unal-edigital2-labs/2021-1-w07_entrega-_final-grupo11/images/Conexion.png

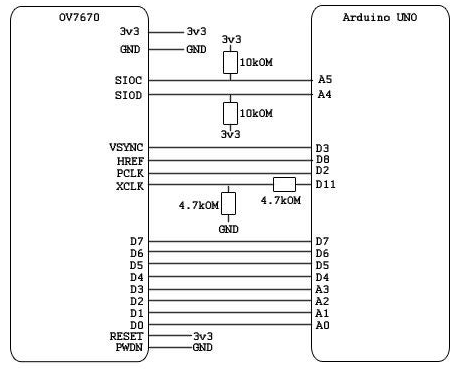
images/Conexion.png
