unal-edigital2-labs/2021-1-w07_entrega-_final-grupo11/images/test.png

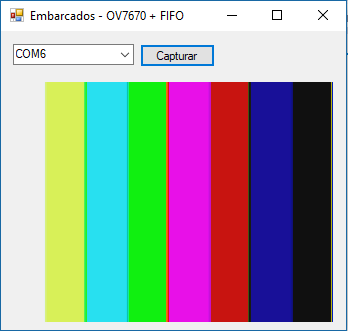
images/test.png
