unal-edigital2-labs/2021-1-w07_entrega-_final-grupo11/module/verilog/clk24_25_nexys4_clk_wiz.v

// file: clk24_25_nexys4.v
// 
// (c) Copyright 2008 - 2013 Xilinx, Inc. All rights reserved.
// 
// This file contains confidential and proprietary information
// of Xilinx, Inc. and is protected under U.S. and
// international copyright and other intellectual property
// laws.
// 
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
// CRITICAL APPLICATIONS
// Xilinx products are not designed or intended to be fail-
// safe, or for use in any application requiring fail-safe
// performance, such as life-support or safety devices or
// systems, Class III medical devices, nuclear facilities,
// applications related to the deployment of airbags, or any
// other applications that could lead to death, personal
// injury, or severe property or environmental damage
// (individually and collectively, "Critical
// Applications"). Customer assumes the sole risk and
// liability of any use of Xilinx products in Critical
// Applications, subject only to applicable laws and
// regulations governing limitations on product liability.
// 
// THIS COPYRIGHT NOTICE AND DISCLAIMER MUST BE RETAINED AS
// PART OF THIS FILE AT ALL TIMES.
// 
//----------------------------------------------------------------------------
// User entered comments
//----------------------------------------------------------------------------
// None
//
//----------------------------------------------------------------------------
//  Output     Output      Phase    Duty Cycle   Pk-to-Pk     Phase
//   Clock     Freq (MHz)  (degrees)    (%)     Jitter (ps)  Error (ps)
//----------------------------------------------------------------------------
// __clk24M__24.00000______0.000______50.0______175.595_____99.281
// __clk25M__25.00000______0.000______50.0______174.188_____99.281
//
//----------------------------------------------------------------------------
// Input Clock   Freq (MHz)    Input Jitter (UI)
//----------------------------------------------------------------------------
// __primary_________100.000____________0.010

`timescale 10ns/1ns

module clk24_25_nexys4_clk_wiz 

 (// Clock in ports
  // Clock out ports
  output        clk24M,
  output        clk25M,
  // Status and control signals
  input         reset,
  output        locked,
  input         clk100M
 );
  // Input buffering
  //------------------------------------
wire clk100M_clk24_25_nexys4;
wire clk_in2_clk24_25_nexys4;
  BUFG clkin1_bufg
   (.O (clk100M_clk24_25_nexys4),
    .I (clk100M));




  // Clocking PRIMITIVE
  //------------------------------------

  // Instantiation of the MMCM PRIMITIVE
  //    * Unused inputs are tied off
  //    * Unused outputs are labeled unused

  wire        clk24M_clk24_25_nexys4;
  wire        clk25M_clk24_25_nexys4;
  wire        clk_out3_clk24_25_nexys4;
  wire        clk_out4_clk24_25_nexys4;
  wire        clk_out5_clk24_25_nexys4;
  wire        clk_out6_clk24_25_nexys4;
  wire        clk_out7_clk24_25_nexys4;

  wire [15:0] do_unused;
  wire        drdy_unused;
  wire        psdone_unused;
  wire        locked_int;
  wire        clkfbout_clk24_25_nexys4;
  wire        clkfbout_buf_clk24_25_nexys4;
  wire        clkfboutb_unused;
    wire clkout0b_unused;
   wire clkout1b_unused;
   wire clkout2_unused;
   wire clkout2b_unused;
   wire clkout3_unused;
   wire clkout3b_unused;
   wire clkout4_unused;
  wire        clkout5_unused;
  wire        clkout6_unused;
  wire        clkfbstopped_unused;
  wire        clkinstopped_unused;
  wire        reset_high;

  MMCME2_ADV
  #(.BANDWIDTH            ("OPTIMIZED"),
    .CLKOUT4_CASCADE      ("FALSE"),
    .COMPENSATION         ("ZHOLD"),
    .STARTUP_WAIT         ("FALSE"),
    .DIVCLK_DIVIDE        (1),
    .CLKFBOUT_MULT_F      (9.750),
    .CLKFBOUT_PHASE       (0.000),
    .CLKFBOUT_USE_FINE_PS ("FALSE"),
    .CLKOUT0_DIVIDE_F     (40.625),
    .CLKOUT0_PHASE        (0.000),
    .CLKOUT0_DUTY_CYCLE   (0.500),
    .CLKOUT0_USE_FINE_PS  ("FALSE"),
    .CLKOUT1_DIVIDE       (39),
    .CLKOUT1_PHASE        (0.000),
    .CLKOUT1_DUTY_CYCLE   (0.500),
    .CLKOUT1_USE_FINE_PS  ("FALSE"),
    .CLKIN1_PERIOD        (10.000))
  mmcm_adv_inst
    // Output clocks
   (
    .CLKFBOUT            (clkfbout_clk24_25_nexys4),
    .CLKFBOUTB           (clkfboutb_unused),
    .CLKOUT0             (clk24M_clk24_25_nexys4),
    .CLKOUT0B            (clkout0b_unused),
    .CLKOUT1             (clk25M_clk24_25_nexys4),
    .CLKOUT1B            (clkout1b_unused),
    .CLKOUT2             (clkout2_unused),
    .CLKOUT2B            (clkout2b_unused),
    .CLKOUT3             (clkout3_unused),
    .CLKOUT3B            (clkout3b_unused),
    .CLKOUT4             (clkout4_unused),
    .CLKOUT5             (clkout5_unused),
    .CLKOUT6             (clkout6_unused),
     // Input clock control
    .CLKFBIN             (clkfbout_buf_clk24_25_nexys4),
    .CLKIN1              (clk100M_clk24_25_nexys4),
    .CLKIN2              (1'b0),
     // Tied to always select the primary input clock
    .CLKINSEL            (1'b1),
    // Ports for dynamic reconfiguration
    .DADDR               (7'h0),
    .DCLK                (1'b0),
    .DEN                 (1'b0),
    .DI                  (16'h0),
    .DO                  (do_unused),
    .DRDY                (drdy_unused),
    .DWE                 (1'b0),
    // Ports for dynamic phase shift
    .PSCLK               (1'b0),
    .PSEN                (1'b0),
    .PSINCDEC            (1'b0),
    .PSDONE              (psdone_unused),
    // Other control and status signals
    .LOCKED              (locked_int),
    .CLKINSTOPPED        (clkinstopped_unused),
    .CLKFBSTOPPED        (clkfbstopped_unused),
    .PWRDWN              (1'b0),
    .RST                 (reset_high));
  assign reset_high = reset; 

  assign locked = locked_int;
// Clock Monitor clock assigning
//--------------------------------------
 // Output buffering
  //-----------------------------------

  BUFG clkf_buf
   (.O (clkfbout_buf_clk24_25_nexys4),
    .I (clkfbout_clk24_25_nexys4));






  BUFG clkout1_buf
   (.O   (clk24M),
    .I   (clk24M_clk24_25_nexys4));


  BUFG clkout2_buf
   (.O   (clk25M),
    .I   (clk25M_clk24_25_nexys4));



endmodule
