unal-edigital2-labs/2021-1-w07_entrega-_final-grupo11/firmware/isr.c

#include <generated/csr.h>
#include <irq.h>
#include <uart.h>


extern void periodic_isr(void);

void isr(void);
void isr(void)
{
	unsigned int irqs;

	irqs = irq_pending() & irq_getmask();
	leds_out_write(irqs);
	if(irqs & (1 << UART_INTERRUPT))
		uart_isr();

}
