unal-edigital2-labs/2021-1-w07_entrega-_final-grupo11/firmware/display.h

#ifndef _DISPLAY
#define _DISPLAY

#define DISPLAY_0 0b00111111
#define DISPLAY_1 0b00000110
#define DISPLAY_2 0b01011011
#define DISPLAY_3 0b01001111
#define DISPLAY_4 0b01100110
#define DISPLAY_5 0b01101101
#define DISPLAY_6 0b01111101
#define DISPLAY_7 0b00000111  
#define DISPLAY_8 0b01111111
#define DISPLAY_9 0b01101111

#define DISPLAY_A 0b01110111
#define DISPLAY_B 0b01111100
#define DISPLAY_C 0b00111001
#define DISPLAY_D 0b01011110
#define DISPLAY_E 0b01111001
#define DISPLAY_F 0b01110001
#define DISPLAY_G 0b00111101
#define DISPLAY_H 0b01110100
#define DISPLAY_I 0b00110000
#define DISPLAY_J 0b00011110
#define DISPLAY_K 0b01110101
#define DISPLAY_L 0b00111000
#define DISPLAY_M 0b00110111
#define DISPLAY_N 0b01010100
#define DISPLAY_O 0b01011100
#define DISPLAY_P 0b01110011
#define DISPLAY_Q 0b01100111
#define DISPLAY_R 0b01010000
#define DISPLAY_S 0b01101101
#define DISPLAY_T 0b01111000
#define DISPLAY_U 0b00111110
#define DISPLAY_V 0b00011100
#define DISPLAY_W 0b01111110
#define DISPLAY_X 0b01110110
#define DISPLAY_Y 0b01101110
#define DISPLAY_Z 0b01011011

#define DISPLAY_DP 0b10000000
#define DISPLAY_TR 0b01000000
#define DISPLAY_UR 0b00001000

void display(char motifs[8]);

#endif
