unal-edigital2-labs/2021-1-w07_entrega-_final-grupo11/(commit log)

2021-08-19 Laberinto en processing
    Código para ver el laberinto de forma grafica
2021-09-02 Agrego mapa de memoria uart
